FeruzTopalov/alrarm_beacon_with_accelerometer/(list of files, drawings)

Other design files:
PCB/layout.lay6
